OakDevel/dsPic-Servo-OakDevel-Edition/README.md

# dsPic-Servo-OakDevel-Edition
Servo Motor Control with dsPic based on YAPSC.
