OakDevel/dsPic-Servo-OakDevel-Edition/(list of files, drawings)

Other design files:
DsPic Servo Salvado Edition V3 SMD/dsPic Servo SALVADO Edition.dsn
