OakDevel/dsPic-Servo-OakDevel-Edition/DsPic Servo Salvado Edition V3 SMD/dsPic Servo SALVADO Edition.kicad_pcb

## KiCad design DsPic Servo Salvado Edition V3 SMD/dsPic Servo SALVADO Edition.kicad_pcb (2017-09-01, last stored version)

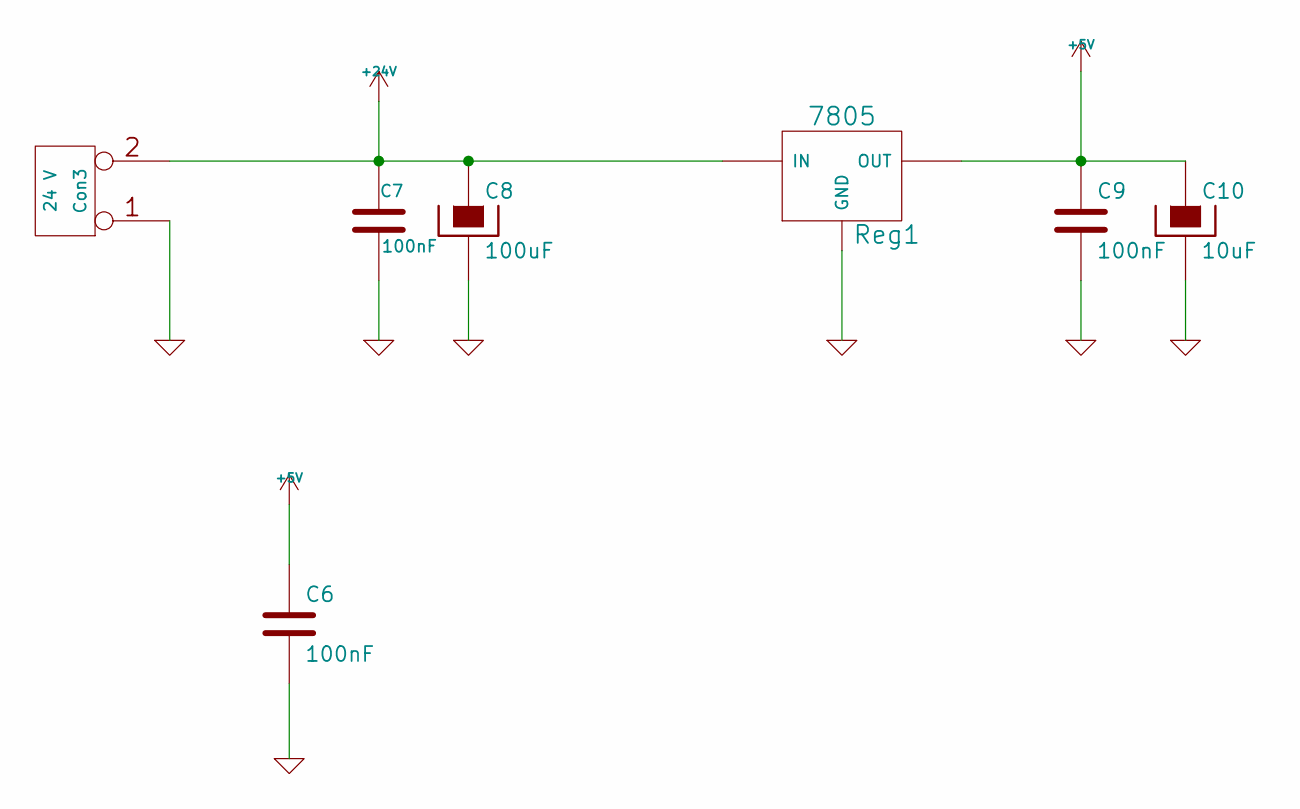
[picture p20: schematic Power Supply.sch, dsPIC Servo]

Parts:
C6, C7, C9: 100nF; CAP-TH-C025-024X044
C8: 100uF; CAP-POL-TH-E2-5
C10: 10uF; CAP-POL-TH-E2-5
Con3: 24 V; CON-PTR500-AK300_2
Reg1: 7805; v-reg-78LXX

Connections:
+5V: C6.1, C9.1, C10.1, Reg1.3 (OUT); also elsewhere on the board
+24V: C7.1, C8.1, Con3.2 (PM), Reg1.1 (IN); also elsewhere on the board
GND: C6.2, C7.2, C8.2, C9.2, C10.2, Con3.1, Reg1.2 (GND); also elsewhere on the board

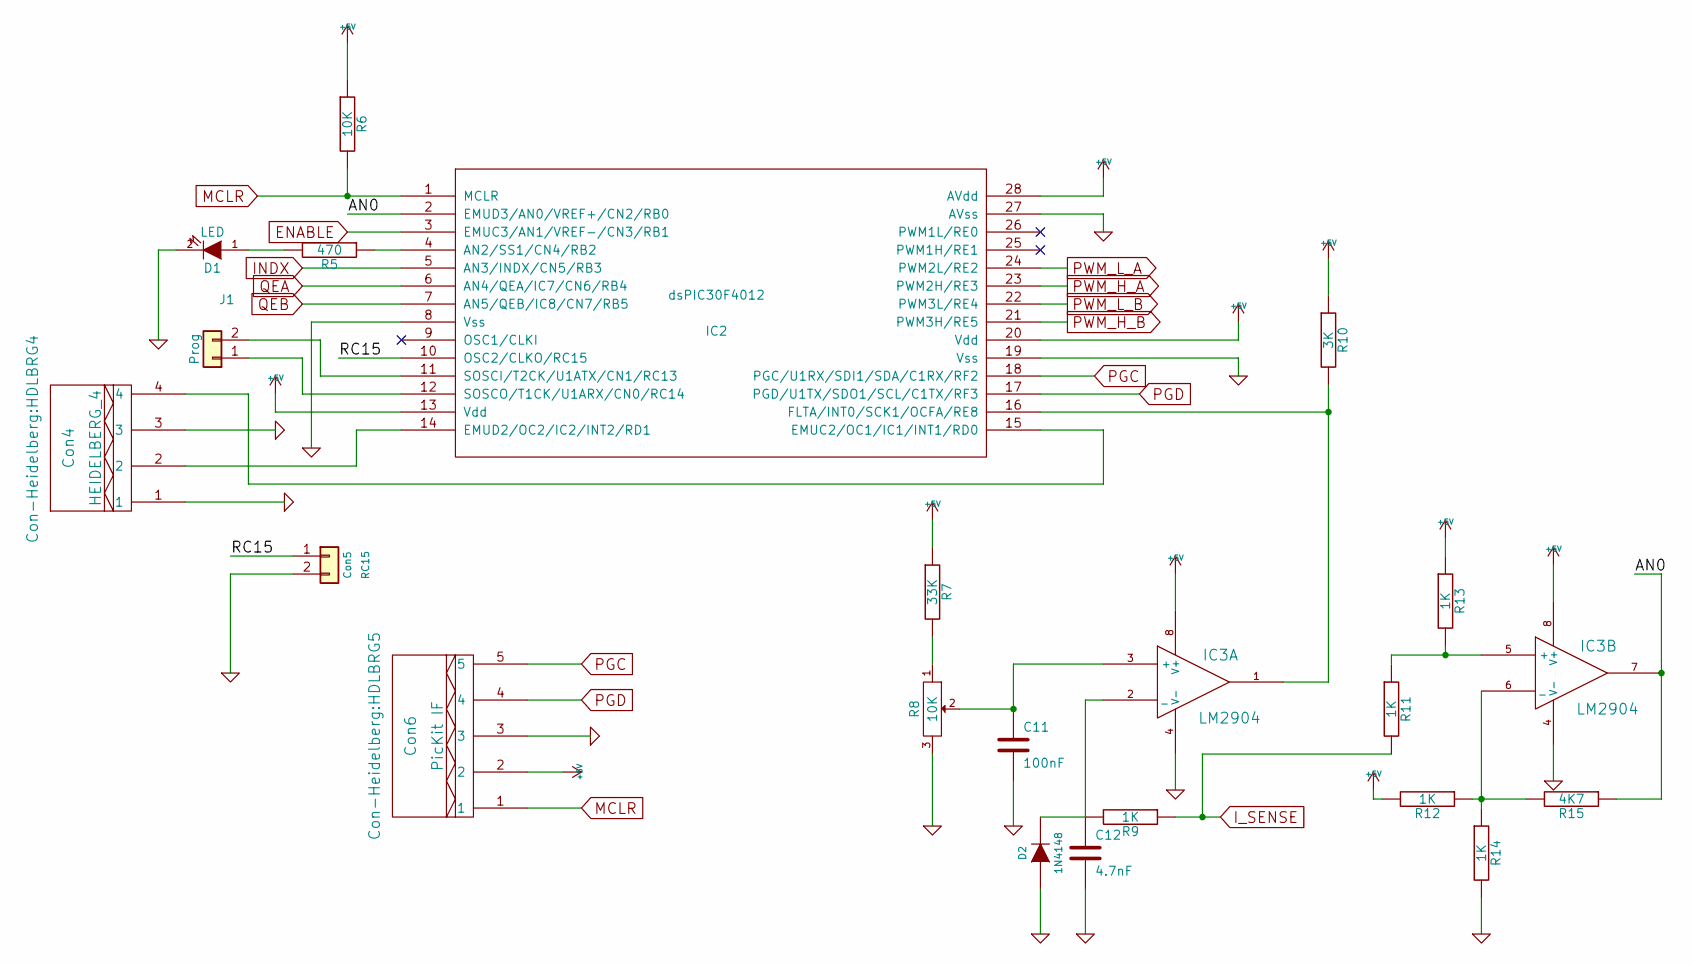
[picture p21: schematic CPU.sch, dsPIC Servo]

Parts:
C11: 100nF; CAP-TH-C025-024X044
C12: 4.7nF; CAP-TH-C025-024X044
Con4: HEIDELBERG_4; HDLBRG4
Con5: RC15; pinhead-1X02
Con6: PicKit IF; HDLBRG5
D1: LED; LED-3MM
D2: 1N4148; DIODE-D-5
IC2: dsPIC30F4012; SO-28W
IC3: LM2904; SO-08
J1: Prog; pinhead-1X02M
R5: 470; RES-TH-0204_7
R6: 10K; RES-TH-0204_7
R7: 33K; RES-TH-0204_7
R8: 10K; POT-TRIM-T93YA
R9, R11, R12, R13, R14: 1K; RES-TH-0204_7
R10: 3K; RES-TH-0204_7
R15: 4K7; RES-TH-0204_7

Connections:
+5V: Con6.2, IC2.13 (Vdd), IC2.20 (Vdd), IC2.28 (AVdd), IC3.8 (V+), R6.1, R7.1, R10.1, R12.2, R13.1; also elsewhere on the board
/CPU/AN0: IC2.2 (EMUD3/AN0/VREF+/CN2/RB0), IC3.7, R15.1
/CPU/RC15: Con5.1, IC2.10 (OSC2/CLKO/RC15)
ENABLE: IC2.3 (EMUC3/AN1/VREF-/CN3/RB1)
GND: C11.2, C12.2, Con4.1, Con4.3, Con5.2, Con6.3, D1.2 (K), D2.A, IC2.8 (Vss), IC2.19 (Vss), IC2.27 (AVss), IC3.4 (V-), R8.3, R14.2; also elsewhere on the board
INDX: IC2.5 (AN3/INDX/CN5/RB3)
I_SENSE: R9.1, R11.2
MCLR: Con6.1, IC2.1 (MCLR), R6.2
unnamed: C11.1, IC3.3 (+), R8.2
unnamed: C12.1, D2.K, IC3.2 (_), R9.2
unnamed: Con4.2, IC2.14 (EMUD2/OC2/IC2/INT2/RD1)
unnamed: Con4.4, IC2.15 (EMUC2/OC1/IC1/INT1/RD0)
unnamed: D1.1 (A), R5.2
unnamed: IC2.4 (AN2/SS1/CN4/RB2), R5.1
unnamed: IC2.11 (SOSCI/T2CK/U1ATX/CN1/RC13), J1.2
unnamed: IC2.12 (SOSCO/T1CK/U1ARX/CN0/RC14), J1.1
unnamed: IC2.16 (FLTA/INT0/SCK1/OCFA/RE8), IC3.1, R10.2
unnamed: IC3.5 (+), R11.1, R13.2
unnamed: IC3.6 (_), R12.1, R14.1, R15.2
unnamed: R7.2, R8.1
PGC: Con6.5, IC2.18 (PGC/U1RX/SDI1/SDA/C1RX/RF2)
PGD: Con6.4, IC2.17 (PGD/U1TX/SDO1/SCL/C1TX/RF3)
PWM_H_A: IC2.23 (PWM2H/RE3); also elsewhere on the board
PWM_H_B: IC2.21 (PWM3H/RE5); also elsewhere on the board
PWM_L_A: IC2.24 (PWM2L/RE2)
PWM_L_B: IC2.22 (PWM3L/RE4)
QEA: IC2.6 (AN4/QEA/IC7/CN6/RB4)
QEB: IC2.7 (AN5/QEB/IC8/CN7/RB5)

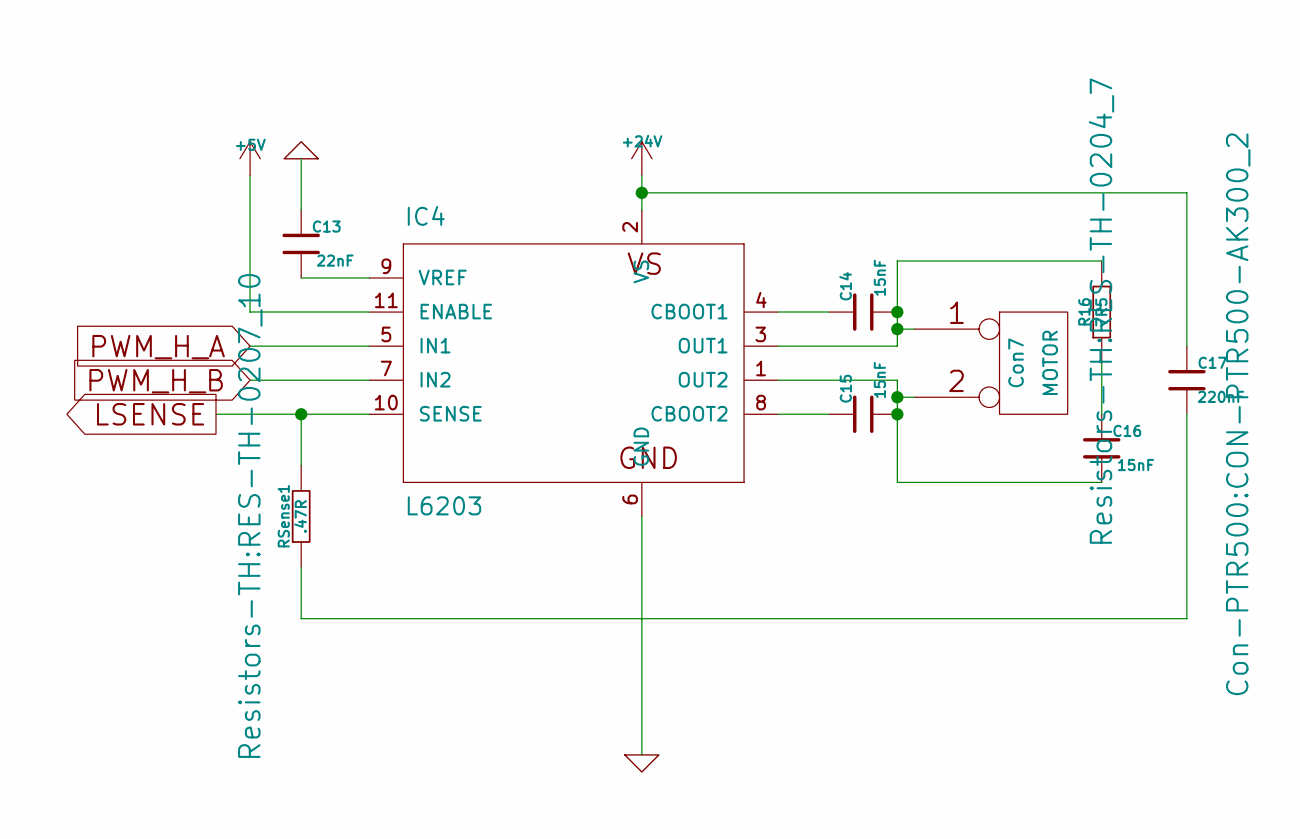
[picture p22: schematic Driver 6203.sch, dsPIC Servo]

Parts:
C13: 22nF; CAP-TH-C025-024X044
C14, C15, C16: 15nF; CAP-TH-C025-024X044
C17: 220nF; CAP-TH-C025-024X044
Con7: MOTOR; CON-PTR500-AK300_2
IC4: L6203; ZIP-11
R16: 7R5; RES-TH-0204_7
RSense1: .47R; RES-TH-0207_10

Connections:
+5V: IC4.11 (ENABLE); also elsewhere on the board
+24V: C17.1, IC4.2 (VS); also elsewhere on the board
GND: C13.1, IC4.6 (GND); also elsewhere on the board
LSENSE: IC4.10 (SENSE), RSense1.2
unnamed: C13.2, IC4.9 (VREF)
unnamed: C14.1, IC4.4 (CBOOT1)
unnamed: C14.2, Con7.1, IC4.3 (OUT1), R16.2
unnamed: C15.1, IC4.8 (CBOOT2)
unnamed: C15.2, C16.2, Con7.2 (PM), IC4.1 (OUT2)
unnamed: C16.1, R16.1
unnamed: C17.2, RSense1.1
PWM_H_A: IC4.5 (IN1); also elsewhere on the board
PWM_H_B: IC4.7 (IN2); also elsewhere on the board

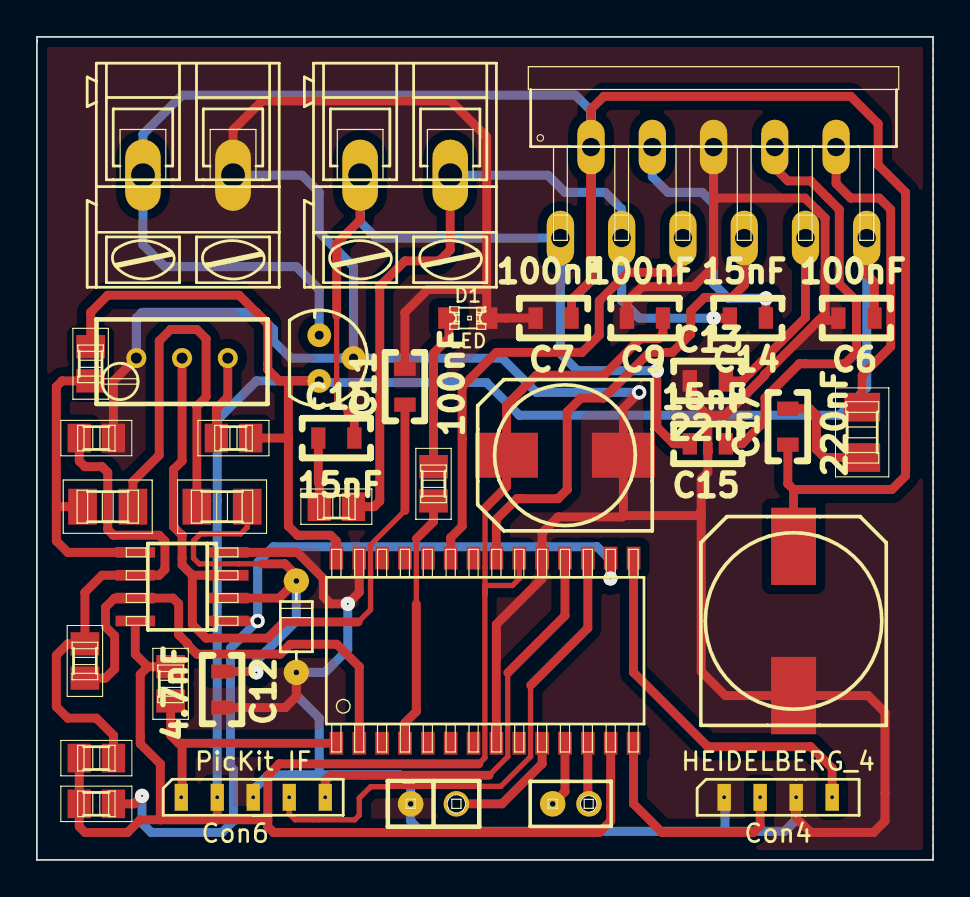
[picture p23: board dsPic Servo SALVADO Edition.kicad_pcb from above]

Board: 2 copper layers, 49.8 x 45.7 mm, 37 parts (0 on the bottom side), 31 nets.
